scottdarch/SpookyEyes/DamnedBoard/README.md

# Birds-of-the-Damned (say it in a spooky voice)

The hardware designs are provided under (Creative Commons Attribution-ShareAlike 3.0)[https://creativecommons.org/licenses/by-sa/3.0/legalcode].

The firmware is provided under Apache 2.0.
