scottdarch/SpookyEyes/BirdsOfTheDamned/DamnedState/NightPhantomMachine.png

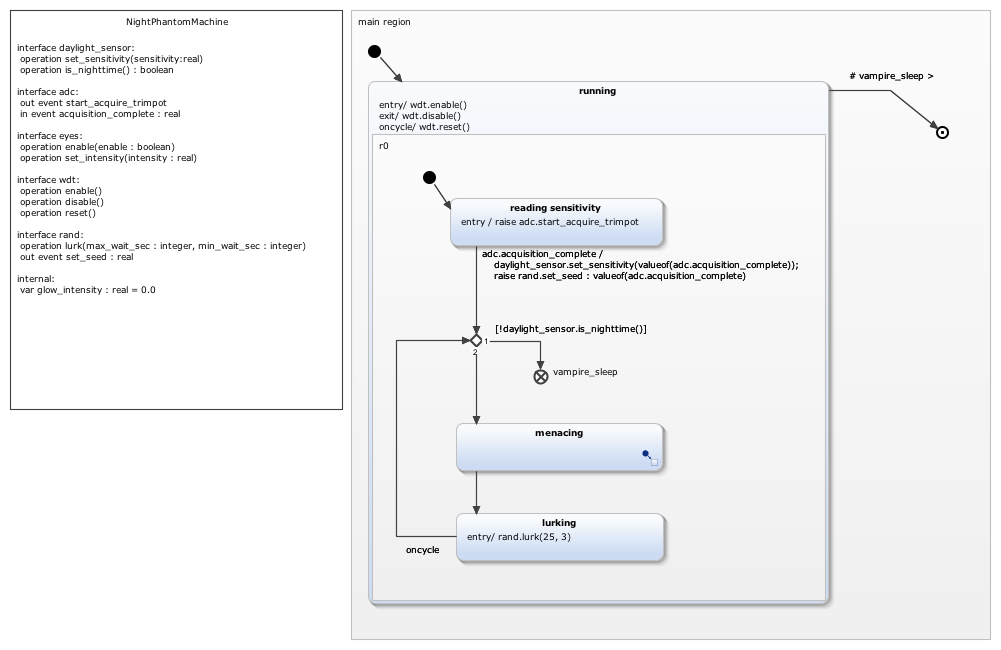
BirdsOfTheDamned/DamnedState/NightPhantomMachine.png
