scottdarch/SpookyEyes/BirdsOfTheDamned/DamnedState/NightPhantomMachine_menacing.png

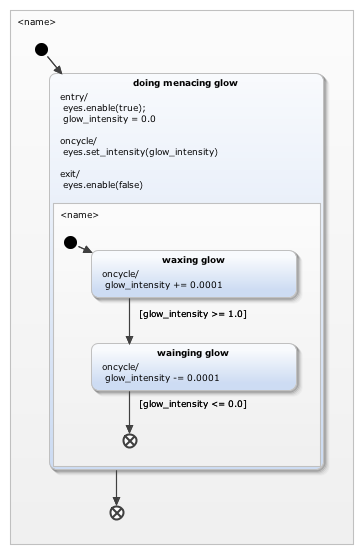
BirdsOfTheDamned/DamnedState/NightPhantomMachine_menacing.png
