scottdarch/SpookyEyes/DamnedBoard/v1.png

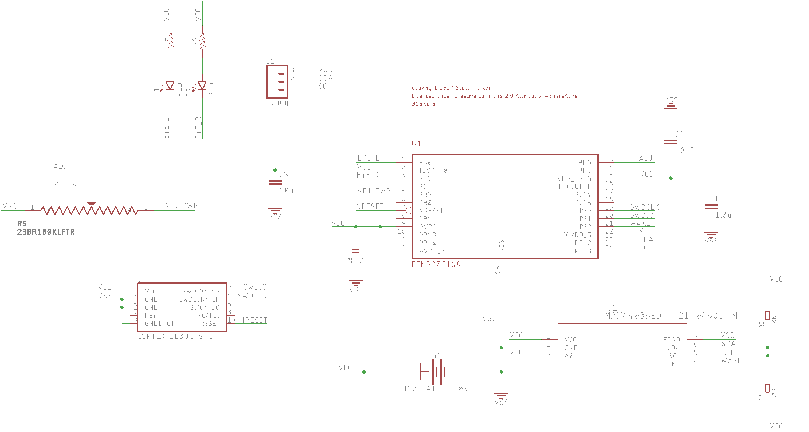
DamnedBoard/v1.png
