scottdarch/SpookyEyes/DamnedBoard/v1.pdf

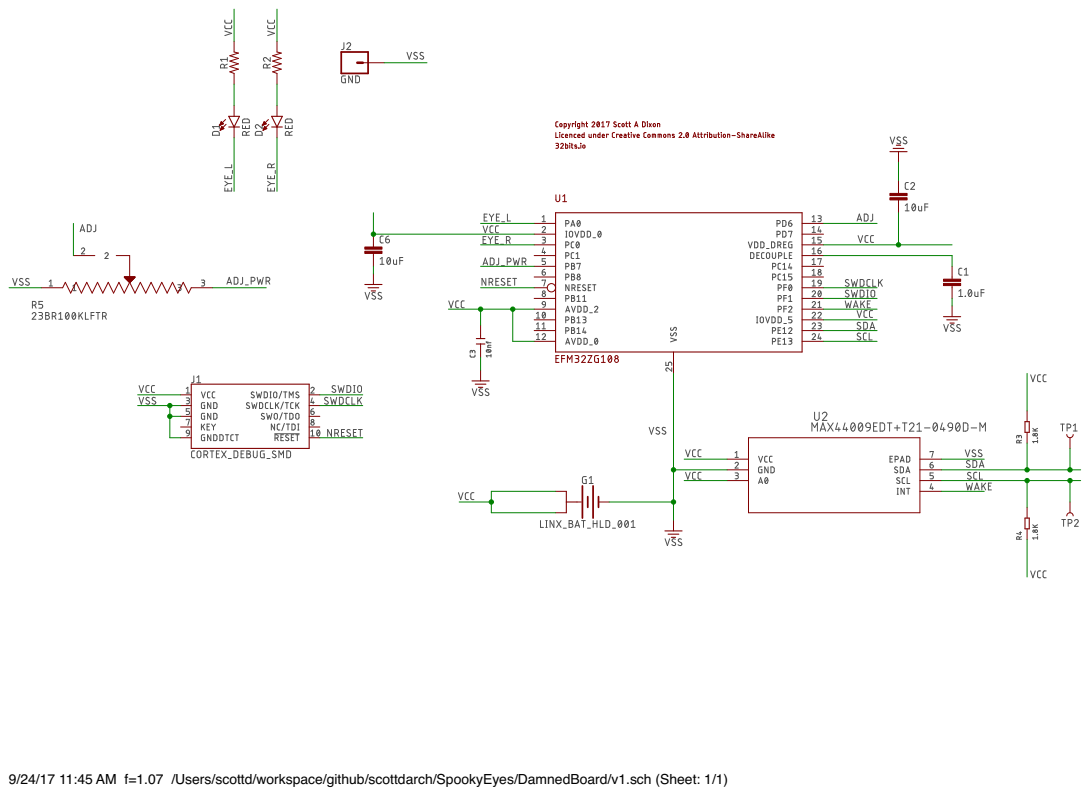
[picture p4: page 1]

9/24/17 11:45 AM f=1.07 /Users/scottd/workspace/github/scottdarch/SpookyEyes/DamnedBoard/v1.sch (Sheet: 1/1)
