scottdarch/SpookyEyes/DamnedBoard/v1.brd

## EAGLE design DamnedBoard/v1.brd (2017-11-14)

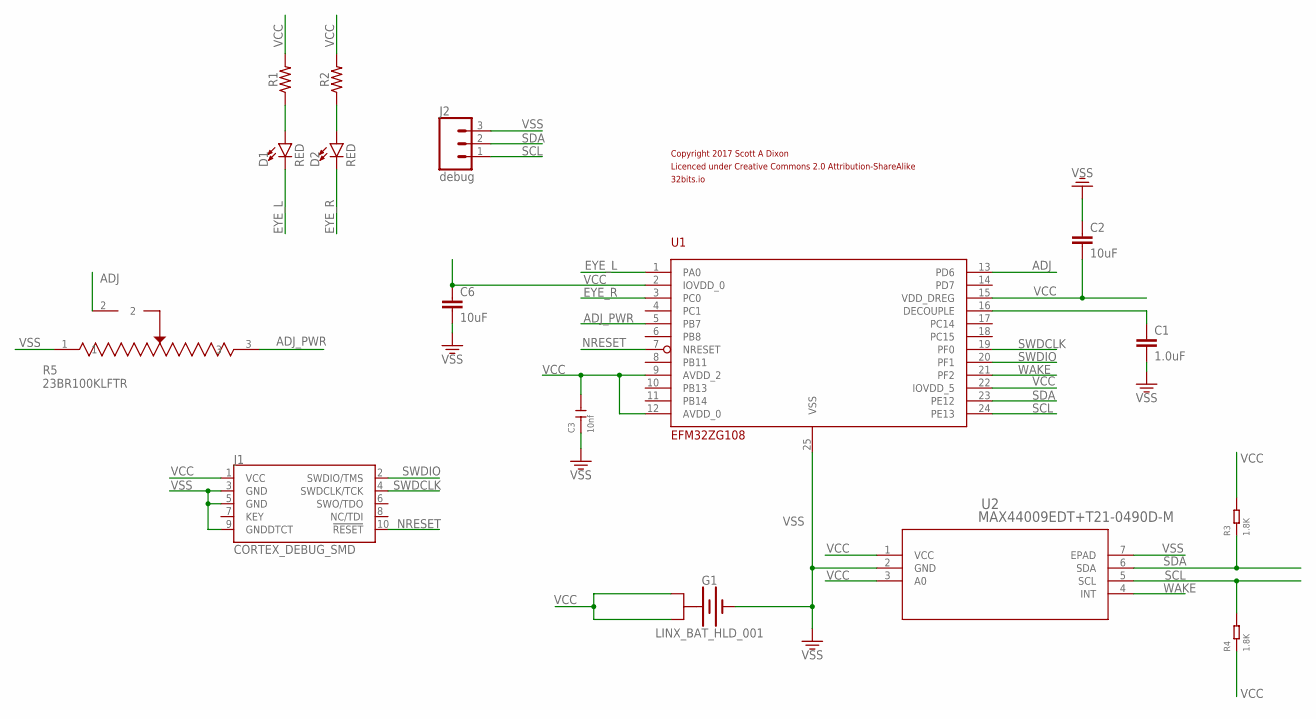
[picture p5: schematic v1.sch]

Parts:
C1: 1.0uF; 0603
C2, C6: 10uF; 0805
C3: 10nf; C0402
D1, D2: RED; LED-1206
G1: LINX_BAT_HLD_001; BATT-RETAINER-20MM
J1: CORTEX_DEBUG_SMD; SAMTECH_FTSH-105-01
J2: debug; 1X03
R1, R2: 68OHM-0603-1/10W-1%; 0603
R3, R4: 1.8K; R0402
R5: 23BR100KLFTR; SOT_23BR100KLFTR
U1: EFM32ZG108; QFN-24
U2: MAX44009EDT+T21-0490D-M; 21-0490D-M
U$1: COPYRIGHT

Connections:
ADJ: R5.2, U1.13 (PD6)
ADJ_PWR: R5.3, U1.5 (PB7)
DCP: C1.1, U1.16 (DECOUPLE)
EYE_L: D1.C, U1.1 (PA0)
EYE_R: D2.C, U1.3 (PC0)
unnamed: D2.A, R2.1
unnamed: D1.A, R1.1
NRESET: J1.10 (!RESET), U1.7 (NRESET)
SCL: J2.1, R4.2, U1.24 (PE13), U2.5 (SCL)
SDA: J2.2, R3.1, U1.23 (PE12), U2.6 (SDA)
SWDCLK: J1.4 (SWDCLK/TCK), U1.19 (PF0)
SWDIO: J1.2 (SWDIO/TMS), U1.20 (PF1)
VCC: C2.2, C3.2, C6.1, G1.P$1 (+$1), G1.P$2 (+$1), G1.P$3 (+$2), G1.P$4 (+$2), J1.1 (VCC), R1.2, R2.2, R3.2, R4.1, U1.2 (IOVDD_0), U1.9 (AVDD_2), U1.12 (AVDD_0), U1.15 (VDD_DREG), U1.22 (IOVDD_5), U2.1 (VCC), U2.3 (A0)
VSS: C1.2, C2.1, C3.1, C6.2, G1.P$0 (-), J1.3 (GND), J1.5 (GND), J1.9 (GNDDTCT), J2.3, R5.1, U1.25 (VSS), U2.2 (GND), U2.7 (EPAD)
WAKE: U1.21 (PF2), U2.4 (INT)

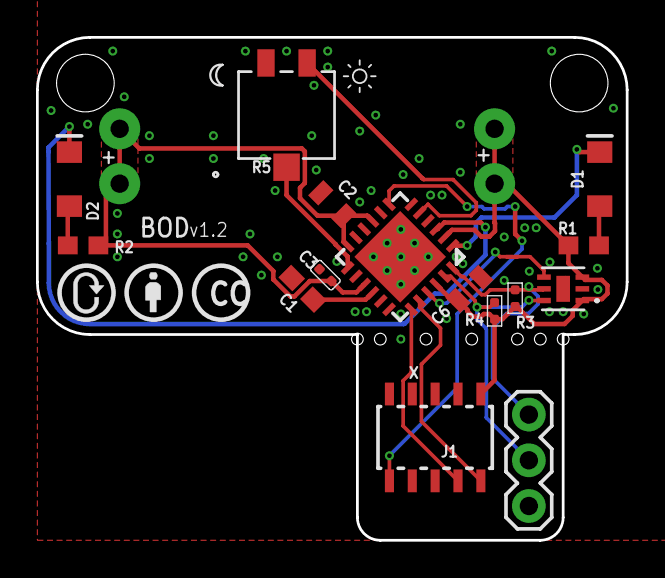
[picture p6: board v1.brd from above]

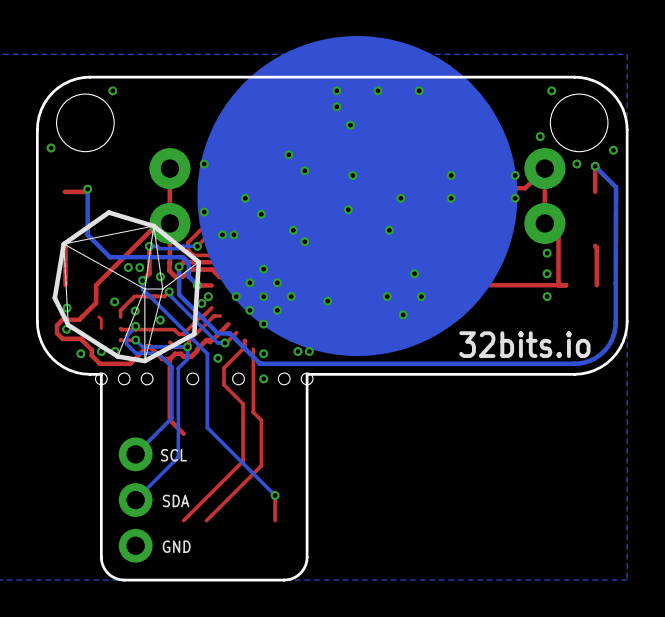
[picture p7: board v1.brd from below]

Board: 2 copper layers, 32.8 x 27.9 mm, 18 parts (2 on the bottom side), 15 nets.

Other parts of the board:
U$2: 32BITS_LOGO
