scottdarch/SpookyEyes/BirdsOfTheDamned/src/DaylightSensor_MAX44009.c

/*
 * Copyright 2017 Scott A Dixon
 *
 * Licensed under the Apache License, Version 2.0 (the "License"); you may not
 * use this file except in compliance with the License. You may obtain a copy of
 * the License at
 *
 * http://www.apache.org/licenses/LICENSE-2.0
 *
 * Unless required by applicable law or agreed to in writing, software distributed
 * under the License is distributed on an "AS IS" BASIS, WITHOUT WARRANTIES OR
 * CONDITIONS OF ANY KIND, either express or implied. See the License for the
 * specific language governing permissions and limitations under the License.
 */

#include "DaylightSensor.h"

// +--------------------------------------------------------------------------+
// | I2C DEFINITIONS
// +--------------------------------------------------------------------------+
// A0@VCC
#define MAX44009_ADDRESS 0x96

#define MAX44009_REG_INT_STAT 0x00
#define MAX44009_REG_INT_EN 0x1
#define MAX44009_REG_CONFIG 0x2
#define MAX44009_REG_LUX_HIGH 0x3
#define MAX44009_REG_LUX_LOW 0x4
#define MAX44009_REG_THRESH_HIGH 0x5
#define MAX44009_REG_THRESH_LOW 0x6
#define MAX44009_REG_THRESH_TIMER 0x7

#define MAX44009_REGIDX_THRES_LOW 2

static uint8_t _reg_config[] = { MAX44009_REG_CONFIG, 0x00 };

// Time delay = (128xT7 + 64xT6 + 32xT5 + 16xT4 + 8xT3 + 4xT2 + 2xT1 + T0) x 100ms
static uint8_t _reg_threshold_timer[] = { MAX44009_REG_THRESH_TIMER, 30 };

// Mantissa (LM[7:4]): Four most significant bits of mantissa lower threshold
// Exponent (LE[3:0]): Exponent bits lower threshold
// Lower lux threshold = 2(exponent) x mantissa x 0.045
// Exponent = 8xLE3 + 4xLE2 + 2xLE1 + LE0
// Mantissa = 128xLM7 + 64xLM6 + 32xLM5 + 16xLM4
static uint8_t _reg_threshold_low[] = { MAX44009_REG_THRESH_LOW, 0x05 };

static uint8_t _reg_int_enable[] = { MAX44009_REG_INT_EN, 0x01 };

static I2C_TransferSeq_TypeDef _config_messages[] = {
    {
        .addr  = MAX44009_ADDRESS,
        .flags = I2C_FLAG_WRITE,
        .buf   = { { _reg_config, 2 },
                   { 0, 0 },
        }
    },
    {
        .addr  = MAX44009_ADDRESS,
        .flags = I2C_FLAG_WRITE,
        .buf   = { { _reg_threshold_timer, 2 },
                   { 0, 0 },
        }
    },
    {
        .addr  = MAX44009_ADDRESS,
        .flags = I2C_FLAG_WRITE,
        .buf   = { { _reg_threshold_low, 2 },
                   { 0, 0 },
        }
    },
    {
        .addr  = MAX44009_ADDRESS,
        .flags = I2C_FLAG_WRITE,
        .buf   = { { _reg_int_enable, 2 },
                   { 0, 0 },
        }
    }
};

static uint8_t _to_low_threshold(float sensitivty) {
    return 0xF & ((uint8_t)(15.0 * sensitivty));
}

// +--------------------------------------------------------------------------+
// | I2C
// +--------------------------------------------------------------------------+
static void daylight_sensor_setup_peripheral(DaylightSensor* self) {
    I2C_TransferReturn_TypeDef last_state = i2cTransferDone;
    static const size_t config_states = sizeof(_config_messages) / sizeof(I2C_TransferSeq_TypeDef);
    size_t config_state_ptr = 0;
    while (config_state_ptr < config_states) {
        if (i2cTransferInProgress == last_state) {
            last_state = I2C_Transfer(self->_i2c_peripheral);
            if (i2cTransferDone == last_state) {
               config_state_ptr++;
            }
        } else {
            last_state = I2C_TransferInit(self->_i2c_peripheral, &(_config_messages[config_state_ptr]) );
        }
    }
}

static void daylight_sensor_reset_interrupt(DaylightSensor* self) {
    I2C_TransferReturn_TypeDef last_state = i2cTransferDone;
    uint8_t register_address = MAX44009_REG_INT_STAT;
    uint8_t reset_status = 0;

    I2C_TransferSeq_TypeDef reset_interrupt = {
            .addr  = MAX44009_ADDRESS,
            .flags = I2C_FLAG_WRITE_READ,
            .buf   = { { &register_address, 1 },
                       { &reset_status, 1 },
            }
        };

    do {
        if (i2cTransferInProgress == last_state) {
            last_state = I2C_Transfer(self->_i2c_peripheral);
        } else {
            last_state = I2C_TransferInit(self->_i2c_peripheral, &reset_interrupt );
        }
    } while(i2cTransferInProgress == last_state);
}

static unsigned int daylight_sensor_get_is_nighttime(DaylightSensor* self) {
    uint8_t lux_low = 0;
    I2C_TransferReturn_TypeDef last_state = i2cTransferDone;
    uint8_t register_address = MAX44009_REG_LUX_HIGH;

    I2C_TransferSeq_TypeDef lux_high = {
            .addr  = MAX44009_ADDRESS,
            .flags = I2C_FLAG_WRITE_READ,
            .buf   = { { &register_address, 1 },
                       { &lux_low, 1 },
            }
        };

    do {
        if (i2cTransferInProgress == last_state) {
            last_state = I2C_Transfer(self->_i2c_peripheral);
        } else {
            last_state = I2C_TransferInit(self->_i2c_peripheral, &lux_high );
        }
    } while(i2cTransferInProgress == last_state);

    return (lux_low <= _reg_threshold_low[1]);
}

static void daylight_sensor_set_sensitivity(DaylightSensor* self, float sensitivity) {
    I2C_TransferReturn_TypeDef last_state = I2C_Transfer(self->_i2c_peripheral);
    _reg_threshold_low[1] = _to_low_threshold(sensitivity);
    while (i2cTransferInProgress == last_state) {
        last_state = I2C_TransferInit(self->_i2c_peripheral, &(_config_messages[MAX44009_REGIDX_THRES_LOW]) );
    }
}

// +--------------------------------------------------------------------------+
// | DaylightSensor
// +--------------------------------------------------------------------------+
DaylightSensor* connect_daylight_sensor_max44009(DaylightSensor* init, I2C_TypeDef* i2c_peripheral) {
    if (init) {
        init->_i2c_peripheral = i2c_peripheral;
        init->get_is_nighttime = daylight_sensor_get_is_nighttime;
        init->reset_interrupt = daylight_sensor_reset_interrupt;
        init->set_sensitivity = daylight_sensor_set_sensitivity;
    }
    return init;
}


DaylightSensor* init_daylight_sensor_max44009(DaylightSensor* init, I2C_TypeDef* i2c_peripheral) {
    init = connect_daylight_sensor_max44009(init, i2c_peripheral);
    if (init) {
        daylight_sensor_setup_peripheral(init);
    }
    return init;
}
