scottdarch/SpookyEyes/BirdsOfTheDamned/DamnedState/src-gen/NightPhantomMachine.h

#ifndef NIGHTPHANTOMMACHINE_H_
#define NIGHTPHANTOMMACHINE_H_

#include "../src/sc_types.h"
		
#ifdef __cplusplus
extern "C" { 
#endif 

/*! \file Header of the state machine 'NightPhantomMachine'.
*/


/*! Enumeration of all states */ 
typedef enum
{
	NightPhantomMachine_last_state,
	NightPhantomMachine_main_region_running,
	NightPhantomMachine_main_region_running_r0_reading_sensitivity,
	NightPhantomMachine_main_region_running_r0_menacing,
	NightPhantomMachine_main_region_running_r0_menacing__region0_doing_menacing_glow,
	NightPhantomMachine_main_region_running_r0_menacing__region0_doing_menacing_glow__region0_waxing_glow,
	NightPhantomMachine_main_region_running_r0_menacing__region0_doing_menacing_glow__region0_wainging_glow,
	NightPhantomMachine_main_region_running_r0_lurking,
	NightPhantomMachine_main_region__final_
} NightPhantomMachineStates;

/*! Type definition of the data structure for the NightPhantomMachineIfaceAdc interface scope. */
typedef struct
{
	sc_boolean start_acquire_trimpot_raised;
	sc_boolean acquisition_complete_raised;
	sc_real acquisition_complete_value;
} NightPhantomMachineIfaceAdc;

/*! Type definition of the data structure for the NightPhantomMachineIfaceRand interface scope. */
typedef struct
{
	sc_boolean set_seed_raised;
	sc_real set_seed_value;
} NightPhantomMachineIfaceRand;

/*! Type definition of the data structure for the NightPhantomMachineInternal interface scope. */
typedef struct
{
	sc_real glow_intensity;
} NightPhantomMachineInternal;


/*! Define dimension of the state configuration vector for orthogonal states. */
#define NIGHTPHANTOMMACHINE_MAX_ORTHOGONAL_STATES 1

/*! Define indices of states in the StateConfVector */
#define SCVI_NIGHTPHANTOMMACHINE_MAIN_REGION_RUNNING 0
#define SCVI_NIGHTPHANTOMMACHINE_MAIN_REGION_RUNNING_R0_READING_SENSITIVITY 0
#define SCVI_NIGHTPHANTOMMACHINE_MAIN_REGION_RUNNING_R0_MENACING 0
#define SCVI_NIGHTPHANTOMMACHINE_MAIN_REGION_RUNNING_R0_MENACING__REGION0_DOING_MENACING_GLOW 0
#define SCVI_NIGHTPHANTOMMACHINE_MAIN_REGION_RUNNING_R0_MENACING__REGION0_DOING_MENACING_GLOW__REGION0_WAXING_GLOW 0
#define SCVI_NIGHTPHANTOMMACHINE_MAIN_REGION_RUNNING_R0_MENACING__REGION0_DOING_MENACING_GLOW__REGION0_WAINGING_GLOW 0
#define SCVI_NIGHTPHANTOMMACHINE_MAIN_REGION_RUNNING_R0_LURKING 0
#define SCVI_NIGHTPHANTOMMACHINE_MAIN_REGION__FINAL_ 0

/*! 
 * Type definition of the data structure for the NightPhantomMachine state machine.
 * This data structure has to be allocated by the client code. 
 */
typedef struct
{
	NightPhantomMachineStates stateConfVector[NIGHTPHANTOMMACHINE_MAX_ORTHOGONAL_STATES];
	sc_ushort stateConfVectorPosition; 
	
	NightPhantomMachineIfaceAdc ifaceAdc;
	NightPhantomMachineIfaceRand ifaceRand;
	NightPhantomMachineInternal internal;
} NightPhantomMachine;


/*! Initializes the NightPhantomMachine state machine data structures. Must be called before first usage.*/
extern void nightPhantomMachine_init(NightPhantomMachine* handle);

/*! Activates the state machine */
extern void nightPhantomMachine_enter(NightPhantomMachine* handle);

/*! Deactivates the state machine */
extern void nightPhantomMachine_exit(NightPhantomMachine* handle);

/*! Performs a 'run to completion' step. */
extern void nightPhantomMachine_runCycle(NightPhantomMachine* handle);


/*! Checks if the out event 'start_acquire_trimpot' that is defined in the interface scope 'adc' has been raised. */ 
extern sc_boolean nightPhantomMachineIfaceAdc_israised_start_acquire_trimpot(const NightPhantomMachine* handle);

/*! Raises the in event 'acquisition_complete' that is defined in the interface scope 'adc'. */ 
extern void nightPhantomMachineIfaceAdc_raise_acquisition_complete(NightPhantomMachine* handle, sc_real value);

/*! Checks if the out event 'set_seed' that is defined in the interface scope 'rand' has been raised. */ 
extern sc_boolean nightPhantomMachineIfaceRand_israised_set_seed(const NightPhantomMachine* handle);

/*! Gets the value of the out event 'set_seed' that is defined in the interface scope 'rand'. */ 
extern sc_real nightPhantomMachineIfaceRand_get_set_seed_value(const NightPhantomMachine* handle);


/*!
 * Checks whether the state machine is active (until 2.4.1 this method was used for states).
 * A state machine is active if it was entered. It is inactive if it has not been entered at all or if it has been exited.
 */
extern sc_boolean nightPhantomMachine_isActive(const NightPhantomMachine* handle);

/*!
 * Checks if all active states are final. 
 * If there are no active states then the state machine is considered being inactive. In this case this method returns false.
 */
extern sc_boolean nightPhantomMachine_isFinal(const NightPhantomMachine* handle);

/*! Checks if the specified state is active (until 2.4.1 the used method for states was called isActive()). */
extern sc_boolean nightPhantomMachine_isStateActive(const NightPhantomMachine* handle, NightPhantomMachineStates state);



#ifdef __cplusplus
}
#endif 

#endif /* NIGHTPHANTOMMACHINE_H_ */
