scottdarch/SpookyEyes/(commit log)

2016-09-18 Starting on bitbang I2C for ATTiny10
2016-09-19 Incremental progress on bitbanged I2C.
2016-09-20 Simplified max44009 driver to fit in attiny10 code size.
2016-09-25 Attiny 10 didn't have pins. Sticking with ATTiny13a.
    [main.c]
2016-10-24 Handling interrupt properly now.
2016-10-25 Switching to low power 128k clock.
2017-08-28 Start of v1 damned board.
    [v1.brd, v1.sch]
2017-08-28 OSH Parkifying layout.
    [v1.brd, v1.sch]
2017-08-29 Progress on layout.
    [v1.brd, v1.sch]
2017-08-30 Candidate for manufacturing.
    [v1.brd, v1.sch]
2017-09-02 Starting on new EFM32 firmware
    [v1.brd]
2017-09-03 Added pullups to i2c
    [v1.brd, v1.sch]
2017-09-04 V1.1 pinout with all tests points.
    [v1.brd, v1.sch]
2017-09-04 Progress on the adjustable version.
    [v1.brd, v1.sch]
2017-09-05 Progress on v1.1
    Added trim pot to use for light threshold adjustment.
    [v1.brd, v1.sch]
2017-09-10 Adding Yakindu machine for firmware.
    [v1.brd, v1.sch]
2017-09-10 Hooking up real sensor logic. x; :x :x
2017-09-10 Working EM4 version of the firmware.
    Also increased pullups to 1.8K for lower power.
    [v1.brd, v1.sch]
2017-09-11 Enabling wdtimer and fixing second eye.
    [DaylightSensor.h, DaylightSensor_MAX44009.c, InitDevice.c, InitDevice.h, Trimmer.h, main.c]
2017-09-14 Moving to ADC for trimmer.
    [v1.brd, v1.sch]
2017-09-18 V1.1 locked. Ordered from OSH park.
    All perphierals working in the firmware. Just need to finish some features and tune.
    [v1.brd, v1.sch]
2017-09-24 Low power lurking implemented.
    TODO:
    1. Proper glow animation.
    2. Read trimpot and calibrate daylight sensor.
    3. Read ADC to get random seed.
    4. use rand to randomize lurk time.
2017-09-24 Adding custom pin names to CS config.
2017-09-25 Adding randomized lurk.
    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
2017-09-26 Adding machine guided glow animation.
    1. Hookup the trimmer to daylight sensitivity.
    2. Fix the unknown energy draw during lurk.
    [BirdHead.c, BirdHead.h, NightPhantomMachine.c, NightPhantomMachine.h, NightPhantomMachineRequired.h, main.c]
2017-10-01 Hooking up ADC and trimpot.
    [v1.brd]
2017-11-14 Adding scheatic png
    [v1.brd, v1.sch]
