scottdarch/SpookyEyes/(notices)

Notices in the files:
parts and their libraries:
boneyard: Licenced under Creative Commons 2.0 Attribution-ShareAlike
SparkFun-LED: Licensing: Creative Commons ShareAlike 4.0 International - https://creativecommons.org/licenses/by-sa/4.0
